w1cmc/garagelights/notes.txt

https://uglyduck.vajn.icu/ep/archive/2014/01/Making_a_better_HC_SR04_Echo_Locator.html
https://www.pcserviceselectronics.co.uk/arduino/Ultrasonic/electronics.html
