w1cmc/garagelights/mechanical/Bourns_3386F/POT_3386F.step

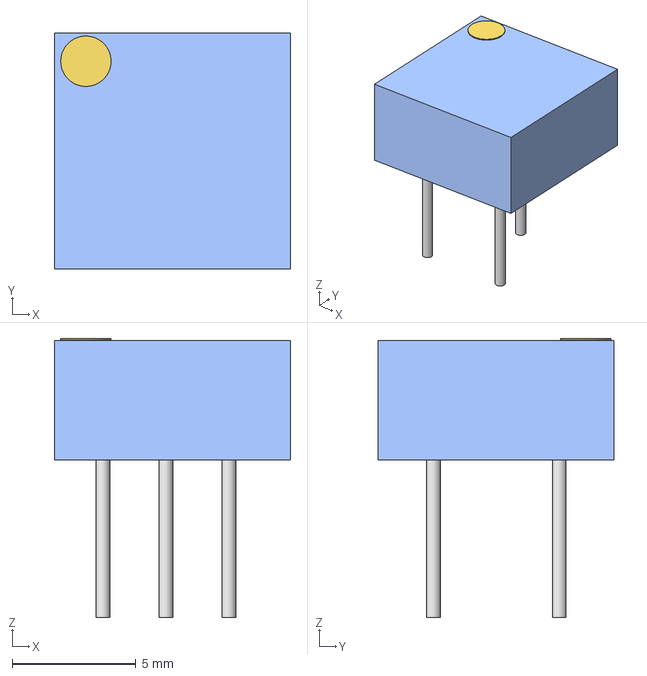
[picture p1: CAD file, 2026-04-26]
mechanical/Bourns_3386F/POT_3386F.step
9.53 x 9.53 x 11.3 mm
