w1cmc/garagelights/mechanical/FreeCAD/Sonar_Holder.FCStd

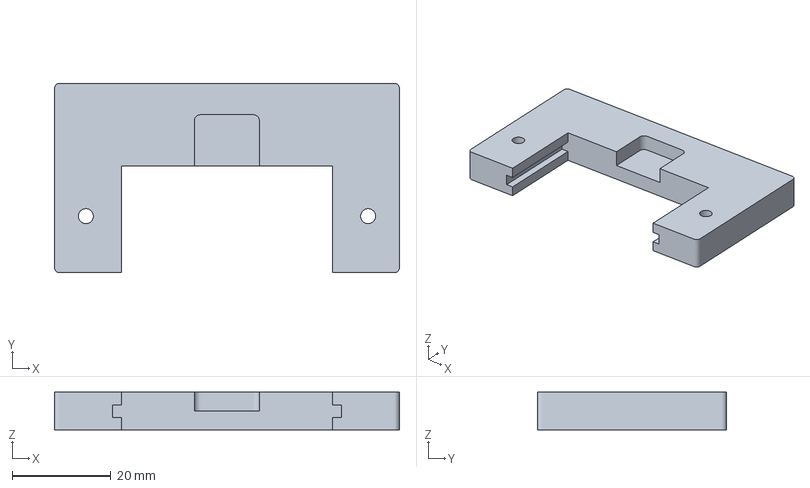
[picture p2: CAD file, 2026-05-07]
mechanical/FreeCAD/Sonar_Holder.FCStd
69.8 x 38.3 x 7.62 mm
