w1cmc/garagelights/mechanical/keystone-PN9900.STEP

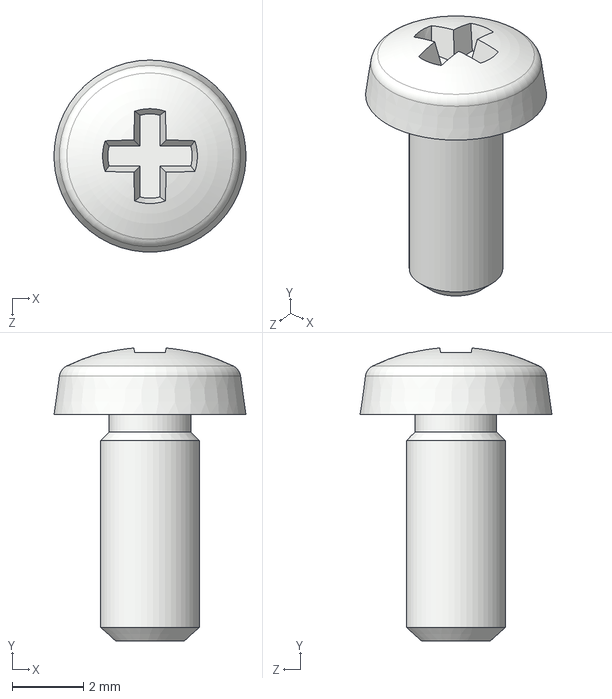
[picture p3: CAD file, 2026-05-08]
mechanical/keystone-PN9900.STEP
5.38 x 8.21 x 5.38 mm
