w1cmc/garagelights/mechanical/Keystone_5006/5006.step

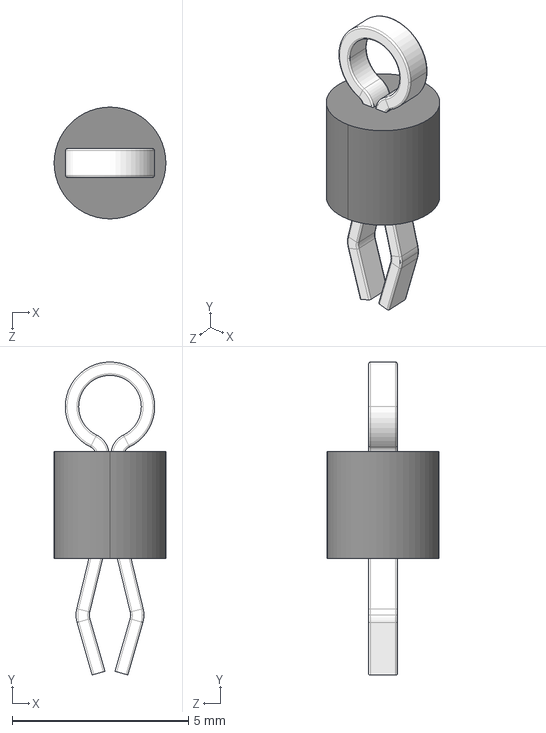
[picture p4: CAD file, 2026-04-10]
mechanical/Keystone_5006/5006.step
3.17 x 8.89 x 3.17 mm
