w1cmc/garagelights/mechanical/Keystone_8714/8714--3DModel-STEP-630548.STEP

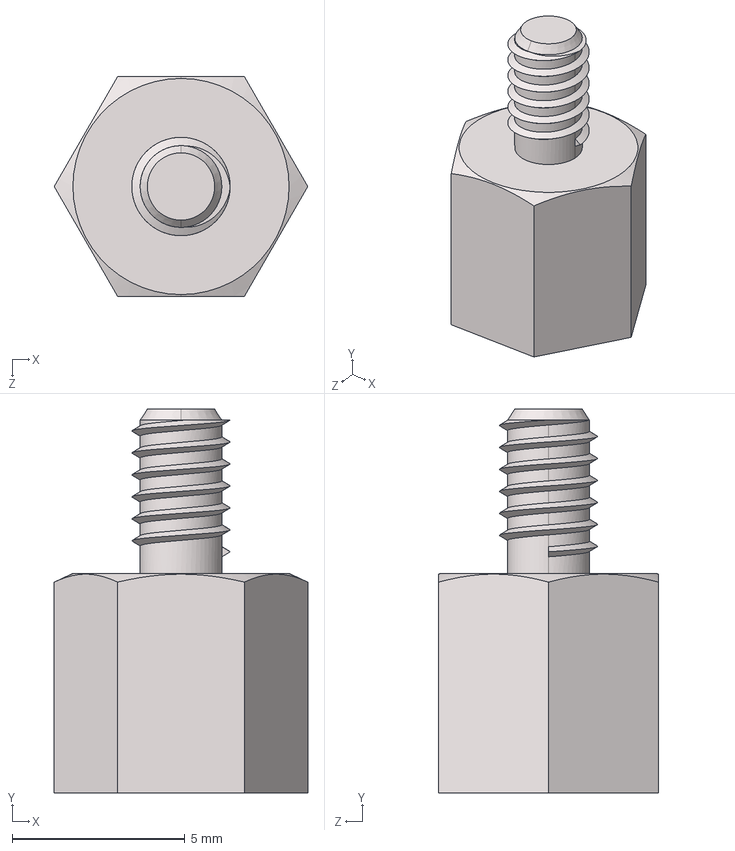
[picture p5: CAD file, 2026-05-04]
mechanical/Keystone_8714/8714--3DModel-STEP-630548.STEP
7.33 x 11.1 x 6.35 mm
