w1cmc/garagelights/mechanical/Schurter_6100_33/6100-33.STEP

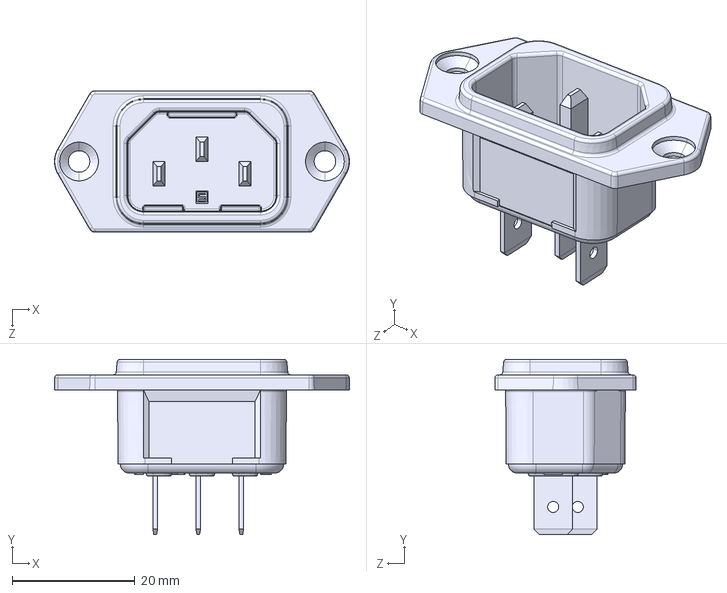
[picture p6: CAD file, 2026-05-04]
mechanical/Schurter_6100_33/6100-33.STEP
48.0 x 28.5 x 23.0 mm
