w1cmc/garagelights/mechanical/SSW-104-03-F-S-RA/SSW-104-03-F-S-RA.step

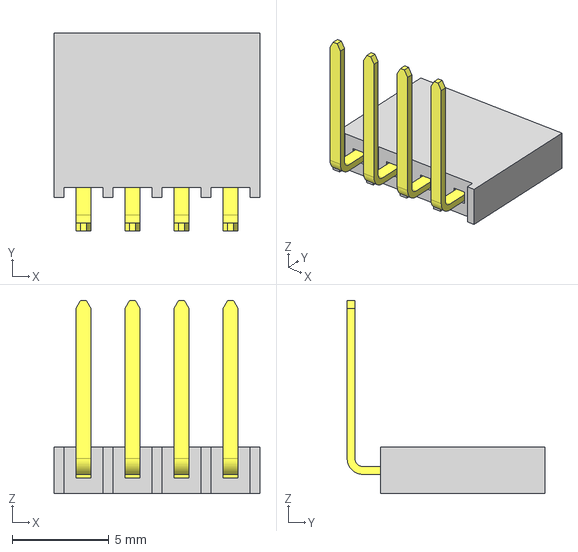
[picture p7: CAD file, 2026-04-10]
mechanical/SSW-104-03-F-S-RA/SSW-104-03-F-S-RA.step
10.7 x 10.2 x 10.0 mm
T1SSW-104-03-F-S-RA
P2SSW-104-03-F-S-RA
