w1cmc/garagelights/mechanical/SSW-106-01-L-S/SSW-106-01-L-S.stp

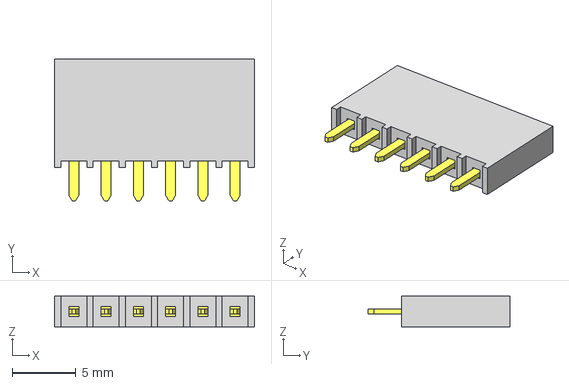
[picture p8: CAD file, 2026-04-10]
mechanical/SSW-106-01-L-S/SSW-106-01-L-S.stp
15.7 x 11.2 x 2.41 mm
T1SSW-106-01-L-S
P2SSW-106-01-L-S
