w1cmc/garagelights/mechanical/FreeCAD/garagelights-Sonar_Holder.step

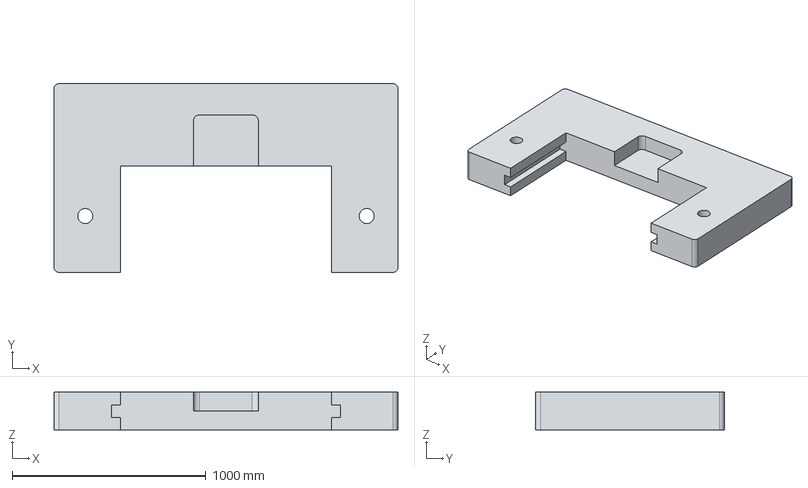
[picture p9: CAD file, 2026-05-07]
mechanical/FreeCAD/garagelights-Sonar_Holder.step
1774.2 x 973.8 x 193.5 mm
