w1cmc/garagelights/mechanical/keystone-PN9901.STEP

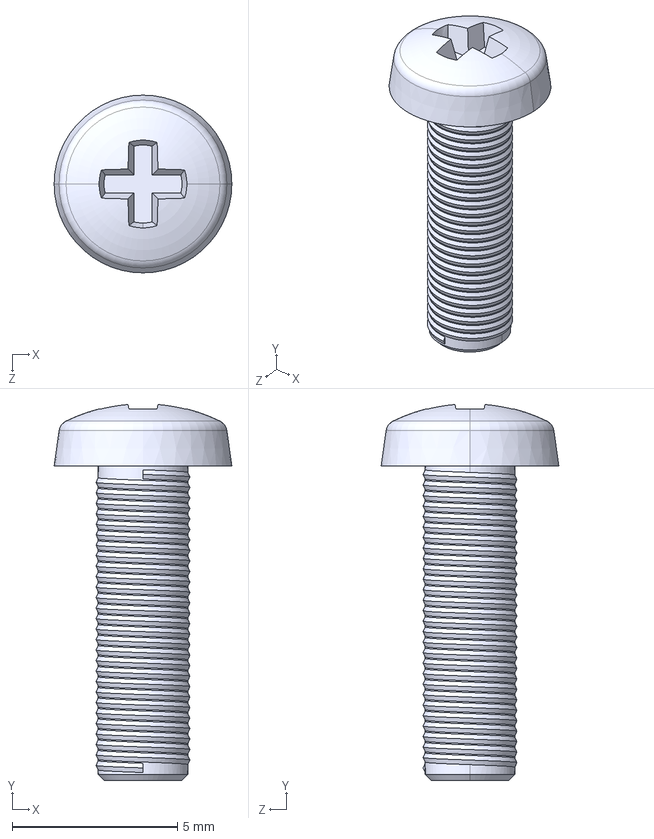
[picture p10: CAD file, 2026-05-08]
mechanical/keystone-PN9901.STEP
5.38 x 11.4 x 5.38 mm
