w1cmc/garagelights/mechanical/FreeCAD/Unnamed.FCStd

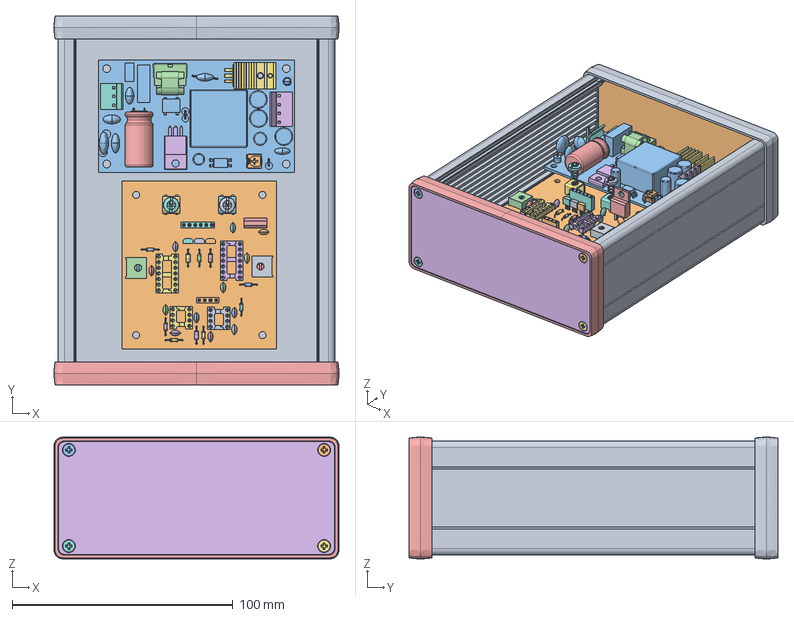
[picture p11: CAD file, 2026-04-09]
mechanical/FreeCAD/Unnamed.FCStd
129.0 x 167.0 x 55.1 mm
Back_Bezel
Back_Face
Back_Screw1
Back_Screw2
Front_Bezel
Front_Face
Front_Screw1
Front_Screw2
Main_Body
Front_Screw3
Front_Screw4
Back_Screw3
Back_Screw4
4-Pin Base 971208
ZPS20 Bed Component (M-B016-01-A) G6620380201
3-Pin Connector (2-Pin) 971208
Countersunk Head Screw M3x8mm — Standard
VR
ZPSA20-PCB (981208) — Configuration
Routed in Defeat — 0902
12.6 mm – 25 mm (For Bamboo Use)
Dangling Pendant: 10mm
Drip-tip: 10mm — Model A
CPD
Lead
Lead001
Lead002
C_Disc_D5.0mm_W2.5mm_P2.50mm
C_Disc_D5.0mm_W2.5mm_P2.50mm001
C_Disc_D5.0mm_W2.5mm_P2.50mm002
C_Disc_D5.0mm_W2.5mm_P2.50mm003
3386P-1-104LF
3386P-1-104LF001
3386P-1-104LF002
3386P-1-104LF003
3386P-1-104LF004
D_DO-35_SOD27_P7.62mm_Horizontal
D_DO-35_SOD27_P7.62mm_Horizontal001
DIP-8_W7.62mm_Socket
C_Disc_D5.0mm_W2.5mm_P2.50mm004
R_Axial_DIN0204_L3.6mm_D1.6mm_P7.62mm_Horizontal
R_Axial_DIN0204_L3.6mm_D1.6mm_P7.62mm_Horizontal001
TO-220-3_Vertical
C_Disc_D5.0mm_W2.5mm_P2.50mm005
CPD001
Lead004
Lead005
Lead006
C_Disc_D5.0mm_W2.5mm_P2.50mm006
D_DO-35_SOD27_P7.62mm_Horizontal003
D_DO-35_SOD27_P7.62mm_Horizontal004
R_Axial_DIN0204_L3.6mm_D1.6mm_P7.62mm_Horizontal002
DIP-8_W7.62mm_Socket001
PinSocket_1x04_P2.54mm_Vertical
C_Disc_D5.0mm_W2.5mm_P2.50mm007
D_DO-35_SOD27_P7.62mm_Horizontal006
D_DO-35_SOD27_P7.62mm_Horizontal007
R_Axial_DIN0204_L3.6mm_D1.6mm_P7.62mm_Horizontal003
DIP-14_W7.62mm_Socket
C_Disc_D5.0mm_W2.5mm_P2.50mm008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
