w1cmc/garagelights/mechanical/keystone-PN9902.STEP

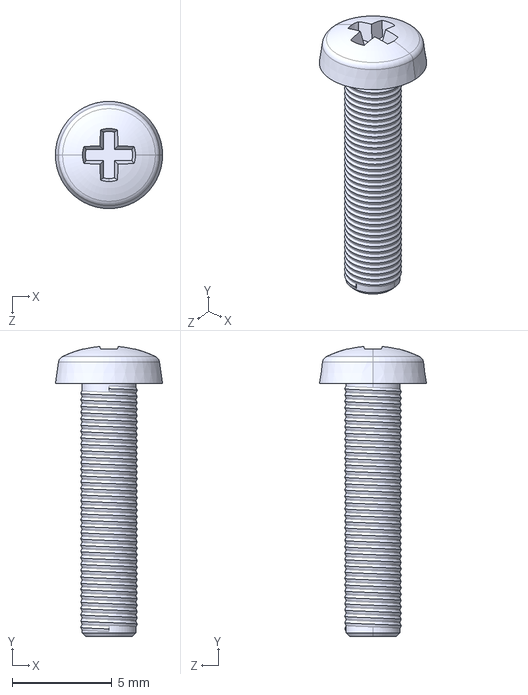
[picture p12: CAD file, 2026-05-08]
mechanical/keystone-PN9902.STEP
5.38 x 14.6 x 5.38 mm
