w1cmc/garagelights/mechanical/RC1122DWC.stp

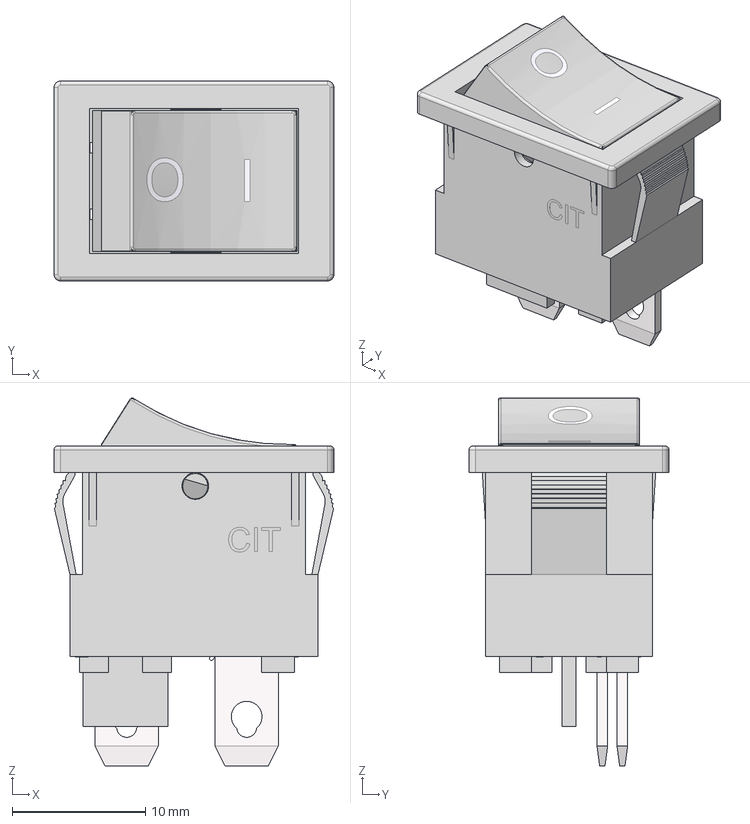
[picture p13: CAD file, 2026-05-04]
mechanical/RC1122DWC.stp
21.0 x 15.0 x 27.6 mm
Body DC
Actuator D
Terminal DC x 2
