w1cmc/garagelights/mechanical/garagelights_RevB.step

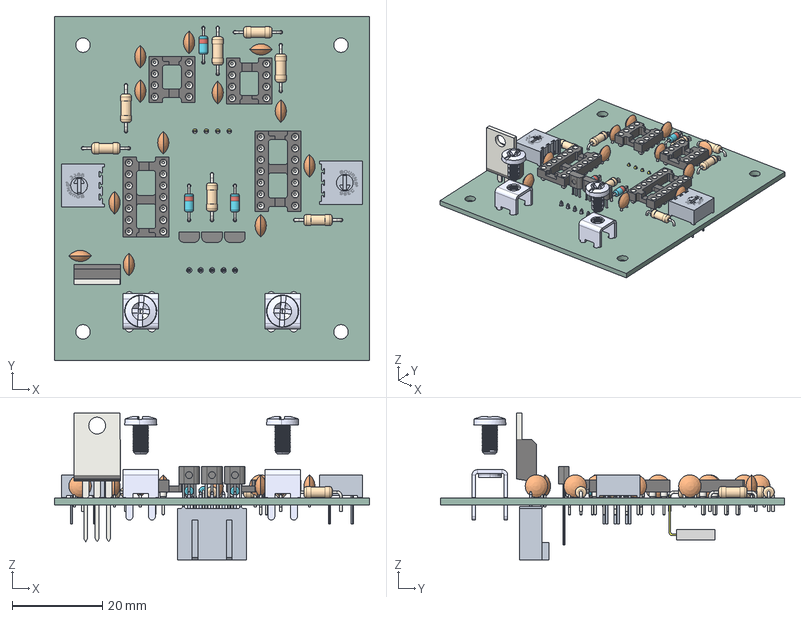
[picture p14: CAD file, 2026-04-28]
mechanical/garagelights_RevB.step
69.8 x 76.2 x 32.5 mm
CPD x 3
Lead x 3
C_Disc_D5.0mm_W2.5mm_P2.50mm x 12
3386f001 x 2
D_DO-35_SOD27_P7.62mm_Horizontal x 3
DIP-8_W7.62mm_Socket x 2
R_Axial_DIN0207_L6.3mm_D2.5mm_P10.16mm_Horizontal x 7
TO-220-3_Vertical
DIP-14_W7.62mm_Socket x 2
T1SSW-104-03-F-S-RA
P2SSW-104-03-F-S-RA
garagelights_PCB
