w1cmc/garagelights/mechanical/zpsa20_3d.step

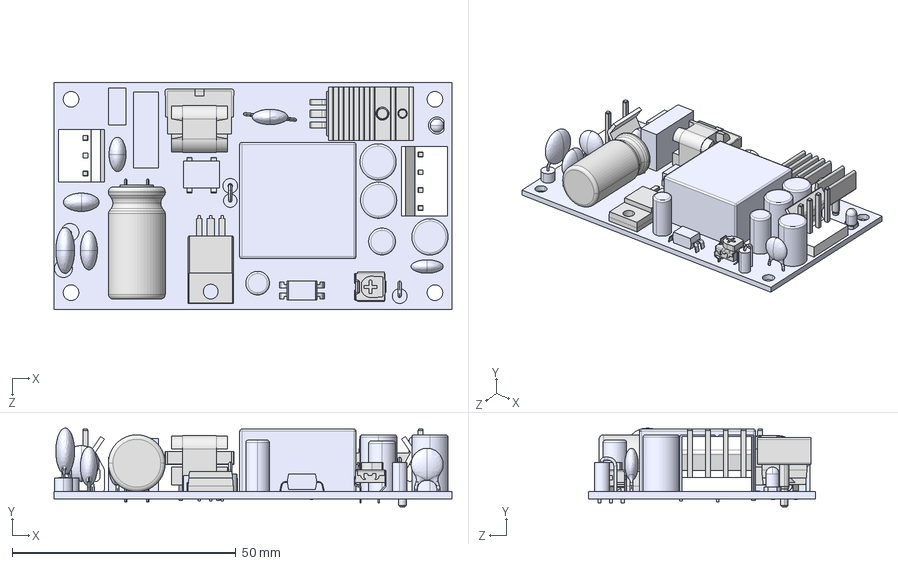
[picture p15: CAD file, 2026-04-09]
mechanical/zpsa20_3d.step
88.9 x 17.6 x 50.8 mm
4 PIN插座971208
ZPS20散熱片(M-B016-01-A)G6620380201
3 PIN插座(2PIN)971208
･ｭﾀY､Qｦrﾁｳｵｷ M3x8mm_ｹwｳ]
VR
ZPSA20-PCBªO(981208)_¹w³]
變壓器0902
12.6mm-25mm電容
電晶體10mm-彎角
電晶體10mm-彎角A
