w1cmc/garagelights/mechanical/3386P-1-104LF.STEP

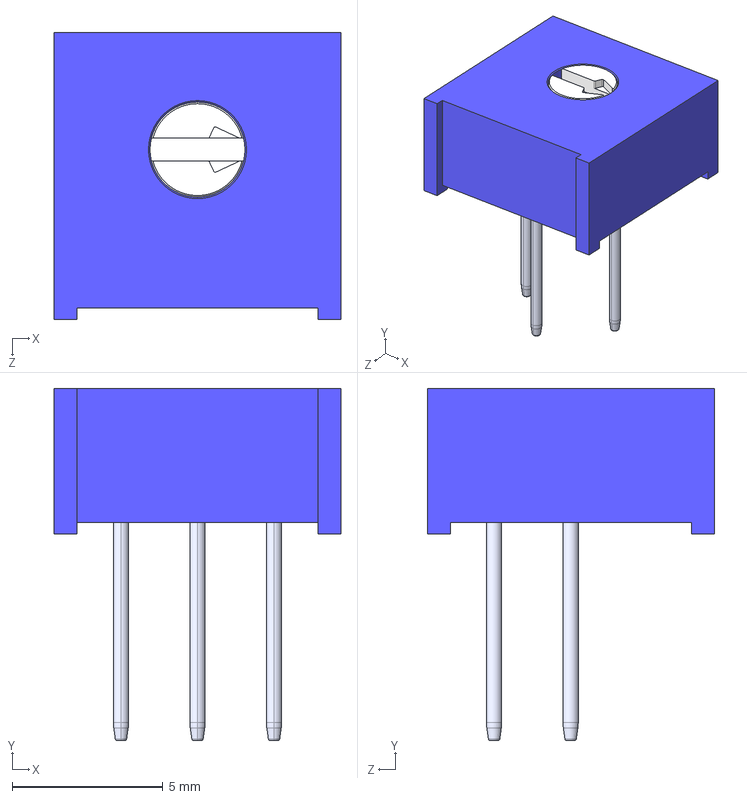
[picture p16: CAD file, 2026-04-09]
mechanical/3386P-1-104LF.STEP
9.53 x 11.7 x 9.53 mm
