w1cmc/garagelights/mechanical/8191.step

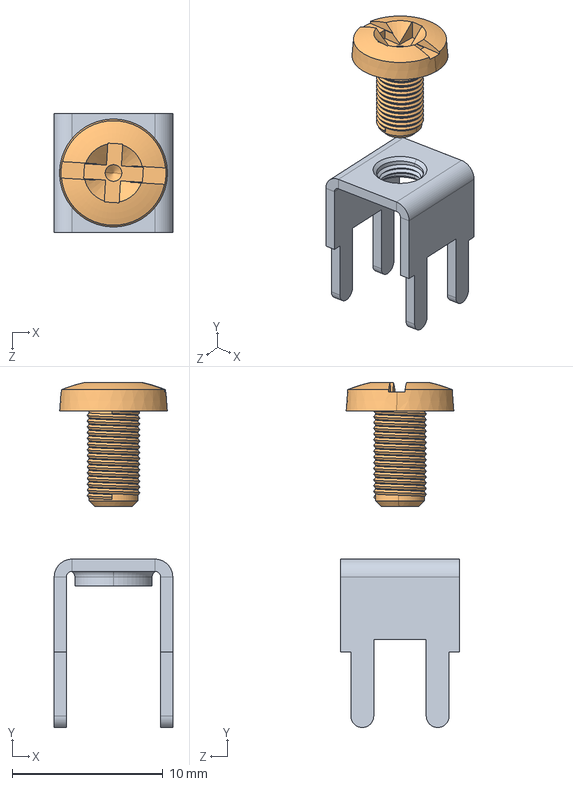
[picture p17: CAD file, 2026-04-09]
mechanical/8191.step
7.87 x 22.9 x 7.87 mm
