w1cmc/garagelights/mechanical/E-Line-BULK.stp

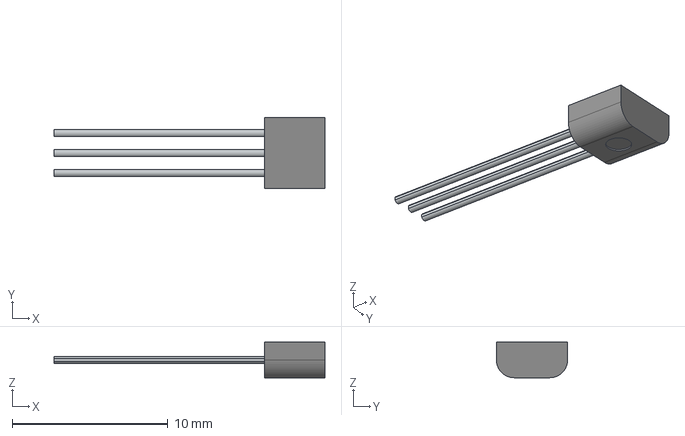
[picture p18: CAD file, 2026-04-09]
mechanical/E-Line-BULK.stp
17.4 x 4.57 x 2.28 mm
CPD
Lead
