w1cmc/garagelights/(list of files, cad)

Other CAD files:
mechanical/Keystone_9900/9900--3DModel-STEP-630548.STEP
mechanical/3686K68_Circuit Board Enclosure.STEP
mechanical/Bourns_3386F/3386f001.stp
mechanical/FreeCAD/garagelights-Sonar_Holder.3mf
mechanical/FreeCAD/garagelights.FCStd
mechanical/Molex_705430004/705430004.stp
mechanical/Molex_901361106/901361106.stp
mechanical/garagelights.step
