w1cmc/garagelights/sim/garagelights.asc

C1: cap; 0.1e-6
C2: cap; 0.1e-6
C3: cap; 0.1e-6
C4: cap; 0.1e-6
D1: diode; 1N914
R1: res; 470k
R2: res; 4.7k
R3: res; 4.7k
R4: res; 100
R5: res; 1
U1: NE555
U2: NE555
V1: voltage; 5
Named nets: 0, OUT, VCC
.tran 1
