w1cmc/garagelights/garagelights.kicad_pcb

## KiCad design garagelights.kicad_pcb (2026-04-27)

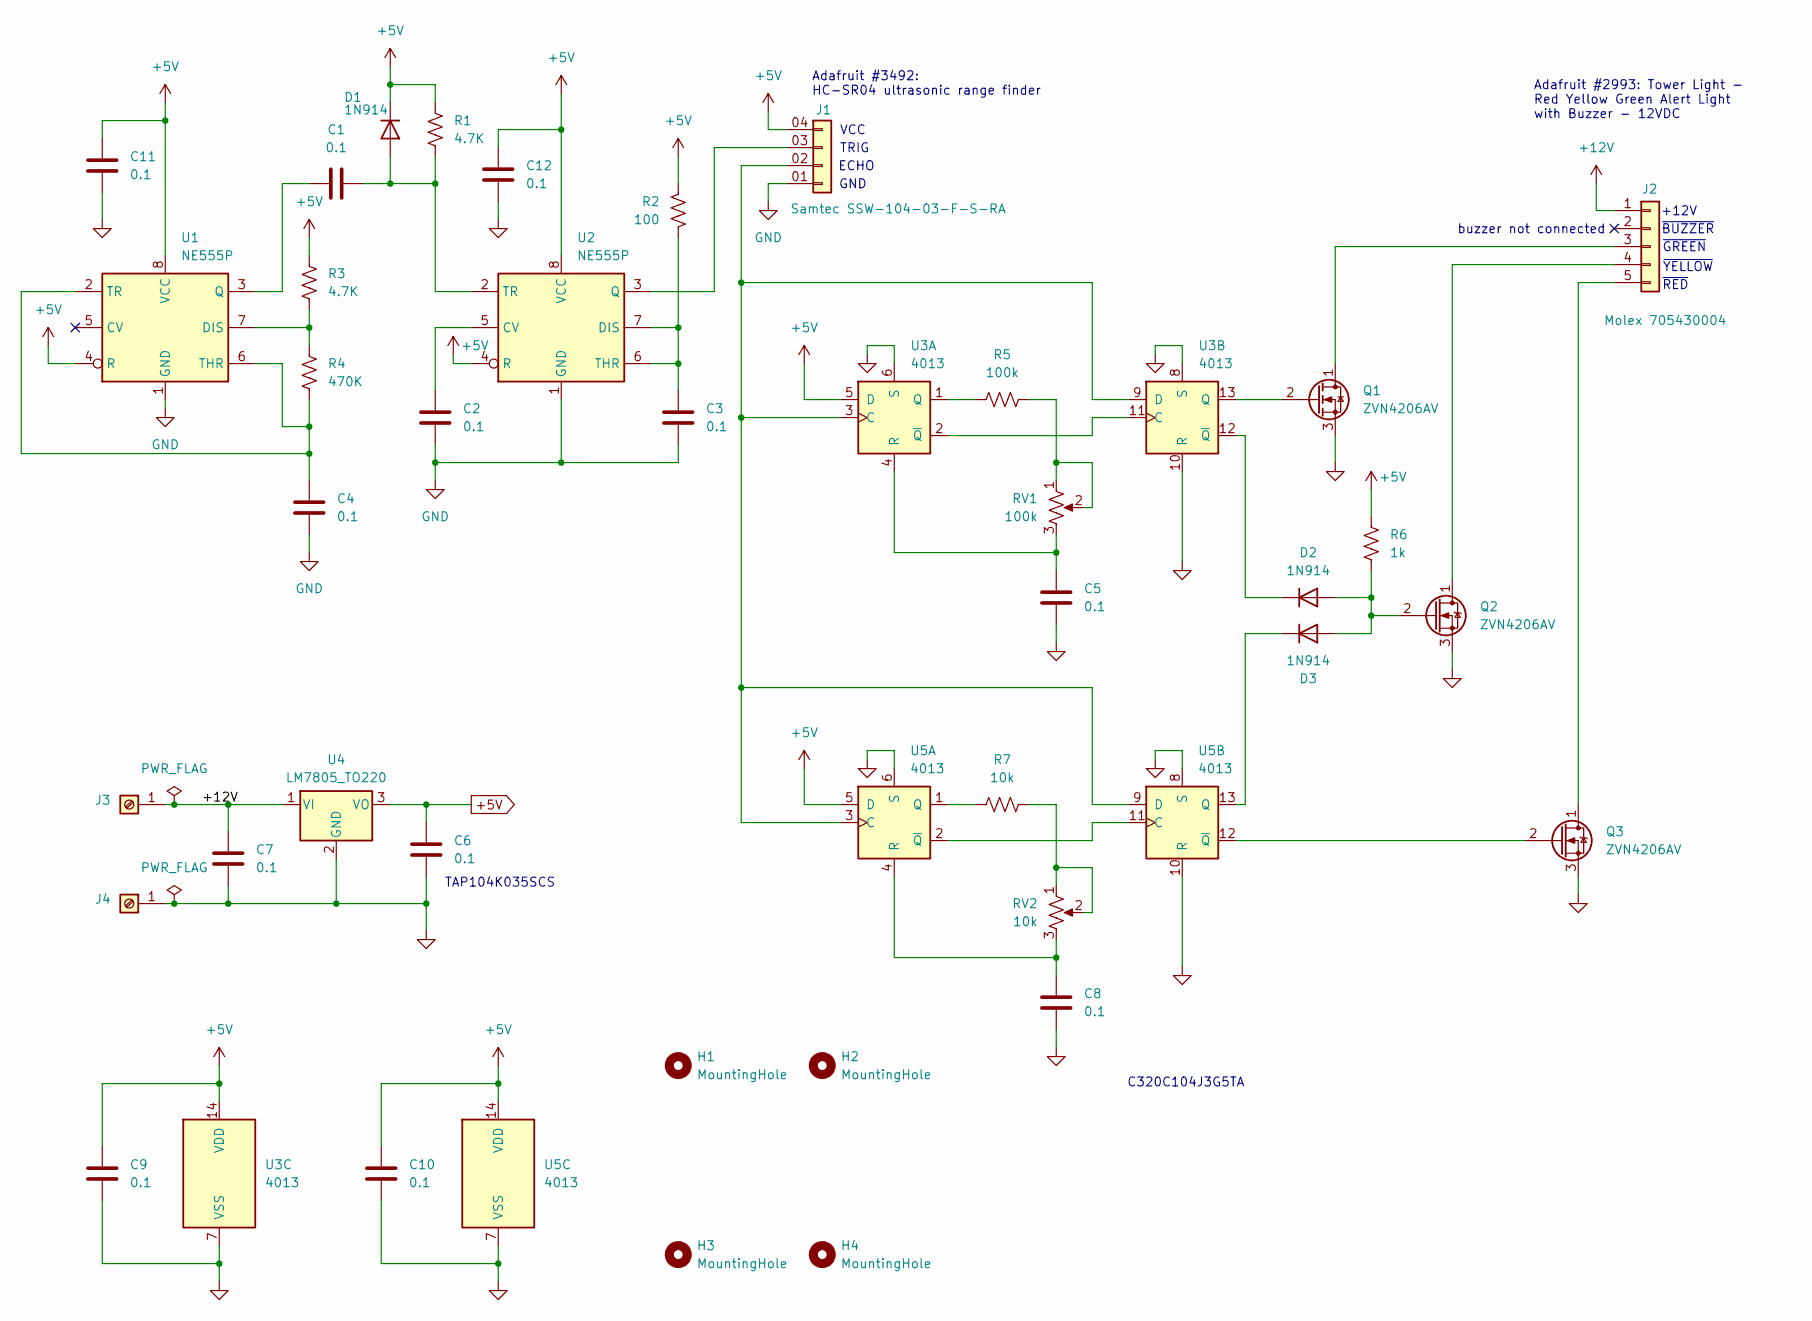
[picture p19: schematic garagelights.kicad_sch, Garage Lights]

Parts:
C1, C2, C3, C4, C5, C6, C7, C8, C9, C10, C11, C12: 0.1; C_Disc_D5.0mm_W2.5mm_P2.50mm
D1, D2, D3: 1N914; D_DO-35_SOD27_P7.62mm_Horizontal
H1, H2, H3, H4: MountingHole; MountingHole_3.2mm_M3
J1: Samtec SSW-104-03-F-S-RA; SAMTEC_SSW-104-03-F-S-RA
J2: Molex 705430004; CONN_SDA-70543-xxxx_05_MOL
J3, J4: Screw_Terminal_01x01; KEYSTONE_8191
Q1, Q2, Q3: ZVN4206AV; TO-92S
R1, R3: 4.7K; R_Axial_DIN0207_L6.3mm_D2.5mm_P10.16mm_Horizontal
R2: 100; R_Axial_DIN0207_L6.3mm_D2.5mm_P10.16mm_Horizontal
R4: 470K; R_Axial_DIN0207_L6.3mm_D2.5mm_P10.16mm_Horizontal
R5: 100k; R_Axial_DIN0207_L6.3mm_D2.5mm_P10.16mm_Horizontal
R6: 1k; R_Axial_DIN0207_L6.3mm_D2.5mm_P10.16mm_Horizontal
R7: 10k; R_Axial_DIN0207_L6.3mm_D2.5mm_P10.16mm_Horizontal
RV1: 100k; POT_3386F
RV2: 10k; POT_3386F
U1, U2: NE555P; DIP-8_W7.62mm_Socket
U3, U5: 4013; DIP-14_W7.62mm_Socket
U4: LM7805_TO220; TO-220-3_Vertical

Connections:
+5V: C6.1, C9.1, C10.1, C11.1, C12.1, D1.1 (K), J1.04 (Pin_1), R1.1, R2.1, R3.1, R6.1, U1.4 (R), U1.8 (VCC), U2.4 (R), U2.8 (VCC), U3.5 (D), U3.14 (VDD), U4.3 (VO), U5.5 (D), U5.14 (VDD)
+12V: C7.1, J2.1, J3.1 (Pin_1_1), U4.1 (VI)
GND: C2.2, C3.2, C4.2, C5.2, C6.2, C7.2, C8.2, C9.2, C10.2, C11.2, C12.2, J1.01 (Pin_4), J4.1 (Pin_1_1), Q1.3 (S), Q2.3 (S), Q3.3 (S), U1.1 (GND), U2.1 (GND), U3.6 (S), U3.7 (VSS), U3.8 (S), U3.10 (R), U4.2 (GND), U5.6 (S), U5.7 (VSS), U5.8 (S), U5.10 (R)
unnamed: C1.2, D1.2 (A), R1.2, U2.2 (TR)
unnamed: D2.2 (A), D3.2 (A), Q2.2 (G), R6.2
unnamed: D2.1 (K), U3.12 (~Q)
unnamed: D3.1 (K), U5.13 (Q)
unnamed: J1.03 (Pin_2), U2.3 (Q)
unnamed: J1.02 (Pin_3), U3.3 (C), U3.9 (D), U5.3 (C), U5.9 (D)
unnamed: J2.3, Q1.1 (D)
unnamed: J2.4, Q2.1 (D)
unnamed: J2.5, Q3.1 (D)
unnamed: Q1.2 (G), U3.13 (Q)
unnamed: Q3.2 (G), U5.12 (~Q)
unnamed: R5.2, RV1.1, RV1.2
unnamed: R7.2, RV2.1, RV2.2
unnamed: R3.2, R4.1, U1.7 (DIS)
unnamed: C1.1, U1.3 (Q)
unnamed: C4.1, R4.2, U1.2 (TR), U1.6 (THR)
unnamed: C2.1, U2.5 (CV)
unnamed: C3.1, R2.2, U2.6 (THR), U2.7 (DIS)
unnamed: R5.1, U3.1 (Q)
unnamed: C5.1, RV1.3, U3.4 (R)
unnamed: U3.2 (~Q), U3.11 (C)
unnamed: R7.1, U5.1 (Q)
unnamed: C8.1, RV2.3, U5.4 (R)
unnamed: U5.2 (~Q), U5.11 (C)

Notes on the sheet:
Adafruit #3492: HC-SR04 ultrasonic range finder
~{GREEN}
TAP104K035SCS
VCC
ECHO
Adafruit #2993: Tower Light - Red Yellow Green Alert Light with Buzzer - 12VDC
GND
buzzer not connected
~{BUZZER}
+12V
TRIG
~{YELLOW}
~{RED}
C320C104J3G5TA

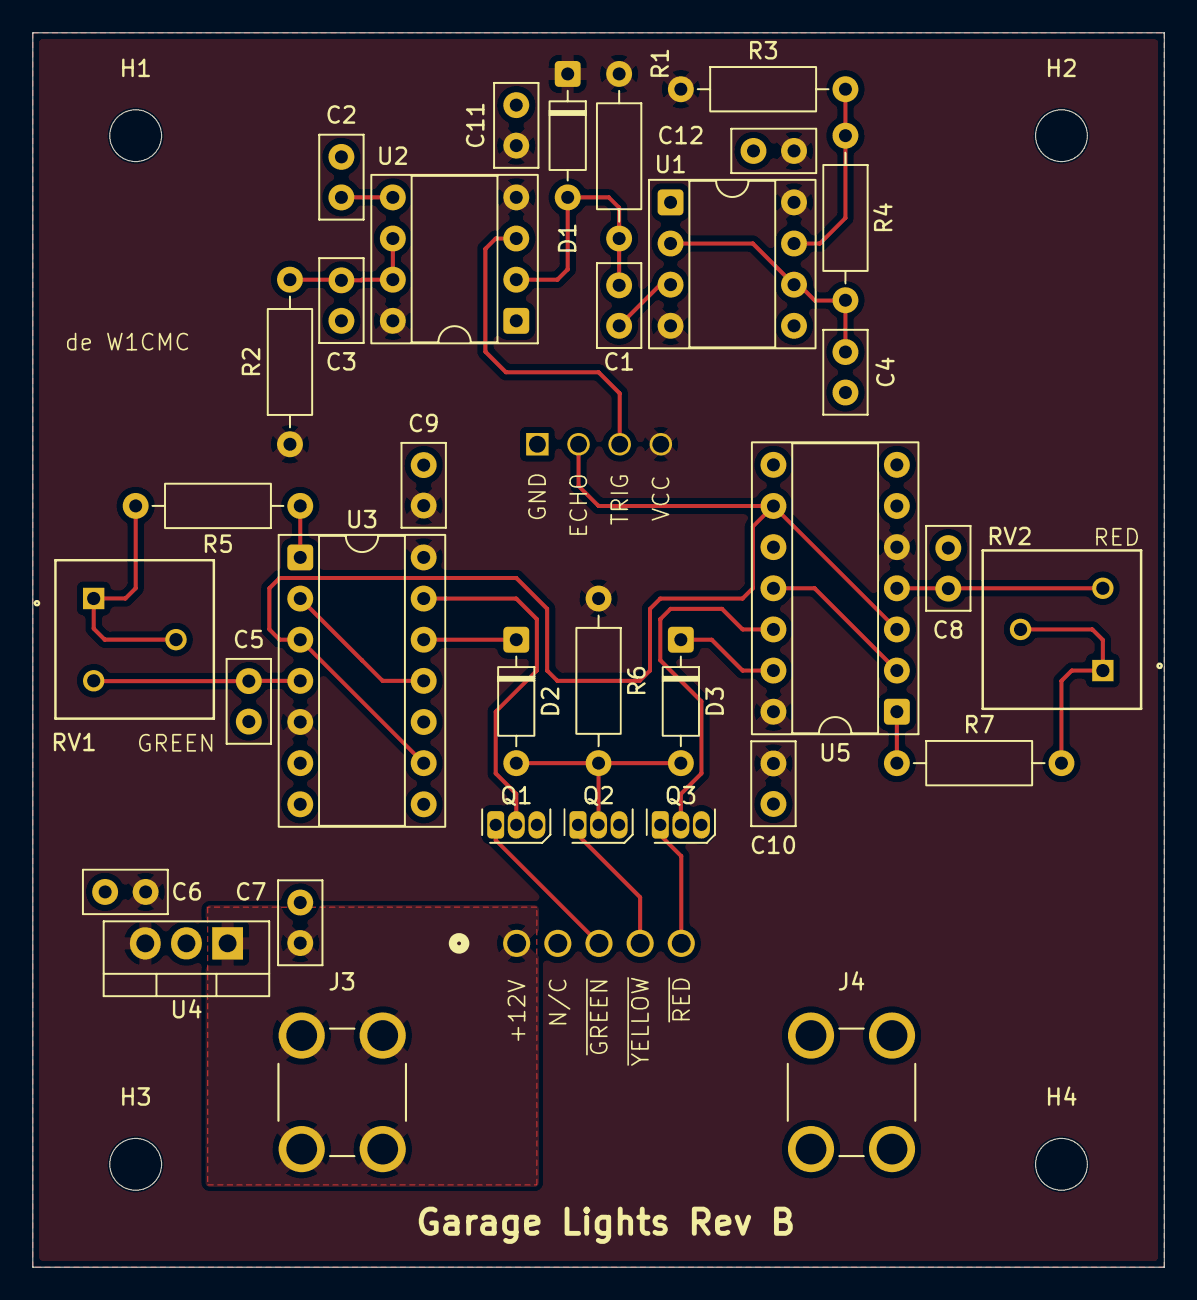
[picture p20: board garagelights.kicad_pcb from above]

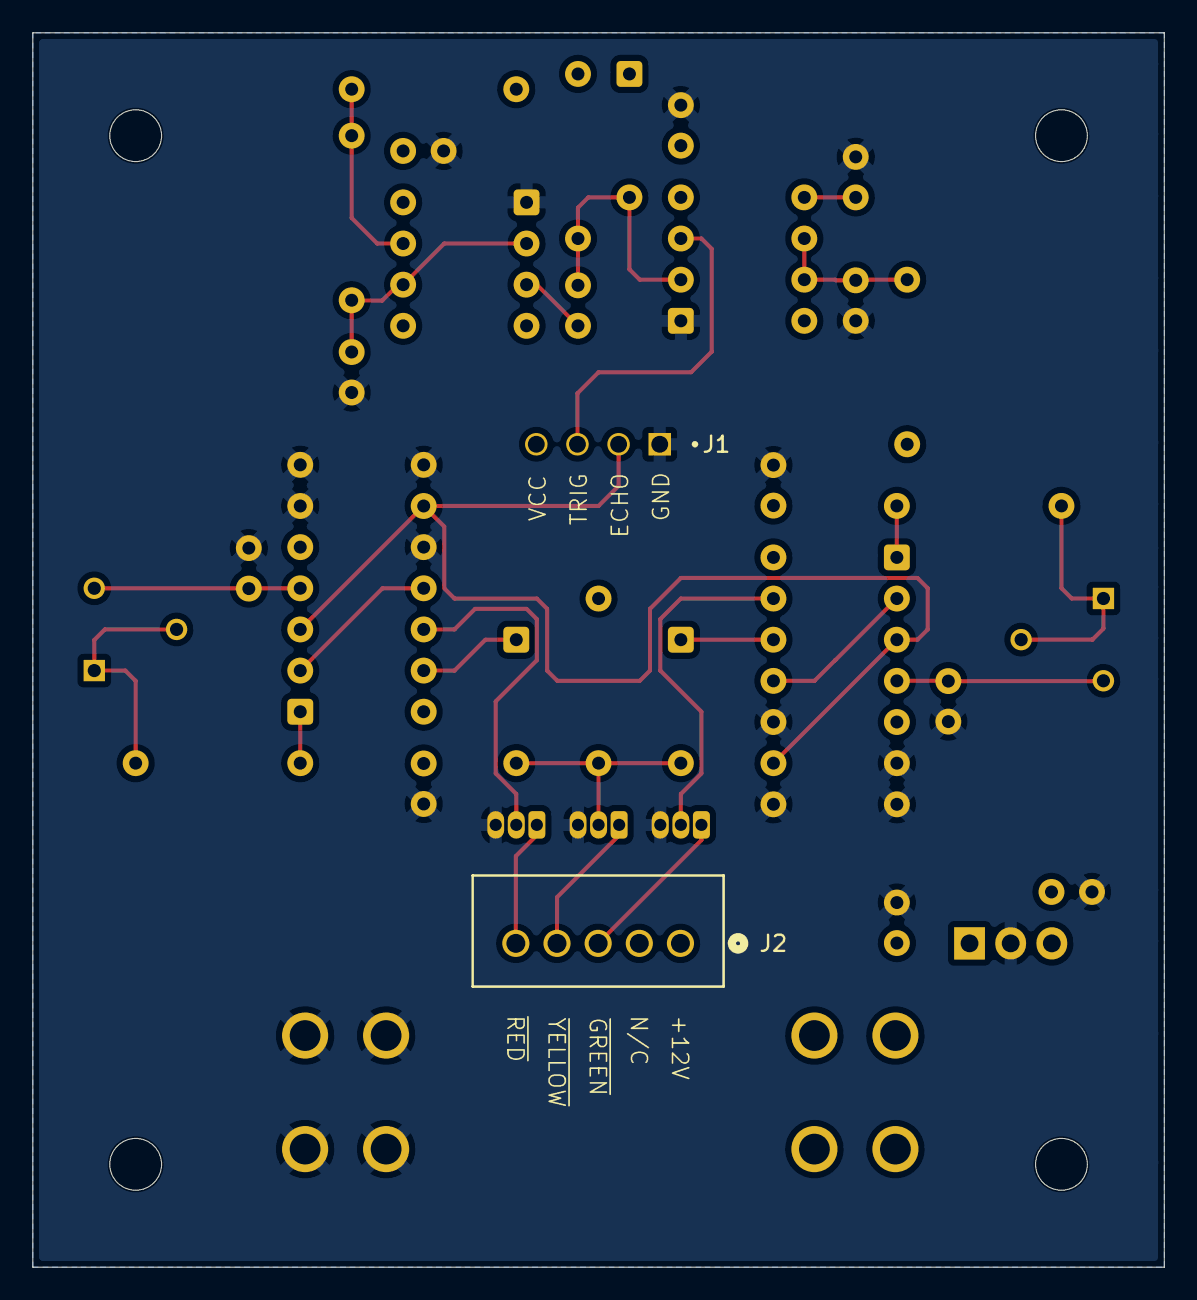
[picture p21: board garagelights.kicad_pcb from below]

Board: 2 copper layers, 69.8 x 76.2 mm, 40 parts (2 on the bottom side), 27 nets.
