w1cmc/garagelights/(commit log)

2025-11-02 First working prototype
    [garagelights.kicad_pcb, garagelights.kicad_sch]
2025-11-03 Added FETs and yellow light
    [garagelights.kicad_sch]
2026-04-08 mostly finished layout
    [garagelights.kicad_pcb, garagelights.kicad_sch]
2026-04-09 Added screw terminals and mounting holes
    Also working towards reducing the number of layers to two.
    [garagelights.kicad_pcb, garagelights.kicad_sch]
2026-04-09 Kinda sorta Rev_A
    Finished the layout and brought it down to two layers, one of which
    is a ground plane. Imported missing 3D models.
    [3386P-1-104LF.STEP, 3686K68_Circuit Board Enclosure.STEP, 8191.step, E-Line-BULK.stp, garagelights.kicad_pcb, garagelights.kicad_sch]
2026-04-09 started mechanical design
    [Unnamed.FCStd, garagelights.kicad_pcb, garagelights.step, zpsa20_3d.step]
2026-04-10 Moved the connectors to the bottom side
    Makes the mechanical design easier. Also some tweaks to reduce
    inductance on the +5V net.
    [garagelights.kicad_pcb]
2026-04-10 Change "PING" to "TRIG" to better match HC-SR04 nomenclature.
    [garagelights.kicad_pcb]
2026-04-10 Spec Samtec connectors for the socket headers.
    Also more fussing with position and text.
    [SSW-104-03-F-S-RA.step, SSW-104-03-F-S-RA.stp, SSW-106-01-L-S.stp, garagelights.kicad_pcb, garagelights.kicad_sch]
2026-04-10 Put the mounting holes into the schematic.
    So that we don't keep losing them when we update the layout from
    the schematic.
    [garagelights.kicad_pcb, garagelights.kicad_sch]
2026-04-10 Rev A: as submitted to Osh Park order #fmnAZ4b4
    [5006.step, 901361106.stp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]
2026-04-11 Added a PWR_FLG and exclusion to clear ERCs
    [garagelights.FCStd, garagelights.kicad_sch]
2026-04-13 Added plot output directory for schematics
2026-04-13 Added LTSpice simulation of the clocking circuit
2026-04-13 git-ignore KiCAD cache and backups
2026-04-15 Changed the timing capacitors: 1 uF ceramic C0G isn't a thing.
    [garagelights.kicad_pcb, garagelights.kicad_sch]
2026-04-26 Update to KiCAD 10.0, replace J2 with 5-pin
    J2 was 6-pin, but the ground pin was superfluous. The light tower
    is switched on the low side, so there is no ground conductor.
    [705430004.stp, garagelights.FCStd, garagelights.kicad_pcb, garagelights.kicad_sch]
2026-04-26 Fixed a couple of boo-boos:
    1. Bigger resistors
    2. Correct footprint for pots
    [3386f001.stp, POT_3386F.step, garagelights.kicad_pcb, garagelights.kicad_sch]
2026-04-27 Outputs for Rev B
    [garagelights-B_Cu.gbr, garagelights-B_Mask.gbr, garagelights-B_Paste.gbr, garagelights-B_Silkscreen.gbr, garagelights-Edge_Cuts.gbr, garagelights-F_Cu.gbr, garagelights-F_Mask.gbr, garagelights-F_Paste.gbr]
2026-04-28 More mechanical work, bump the revision letter on the Schematic
    Mostly done with mechanical holes and pockets.
    [garagelights.FCStd, garagelights.kicad_sch, garagelights_RevB.step]
2026-05-04 Added power entry and switch
    [6100-33.STEP, 8714--3DModel-STEP-630548.STEP, 9900--3DModel-STEP-630548.STEP, RC1122DWC.stp, garagelights.FCStd]
2026-05-05 Added HC-SR04 model to the mechanical design.
    [garagelights.FCStd]
2026-05-05 Added BoM
    [garagelights.csv]
2026-05-05 more churn; made changes and then unmade them
    [garagelights.FCStd]
2026-05-06 added sonar holder
    [garagelights.FCStd]
2026-05-07 Exported STEP file for sonar holder
    [garagelights-Sonar_Holder.step]
2026-05-07 Refinements to sonar holder
    The constraints are better: a single value sets the clearance
    around the HC-SR04 PCB.
    [garagelights.FCStd]
2026-05-07 add 3-d print files
    [Sonar_Holder.FCStd, garagelights-Sonar_Holder.3mf]
2026-05-08 Added long screws through sonar holder.
    And STEP file for short screws.
    [garagelights.FCStd, keystone-PN9901.STEP, keystone-PN9902.STEP]
2026-05-08 Added the short screws.
    [garagelights.FCStd, keystone-PN9900.STEP]
2026-05-24 Move the power entry mechanicals to a subdirectory.
    Schurter 6100-33.
    [6100-33.STEP]
