w1cmc/garagelights/(notices)

Notices in the files:
mechanical/SSW-106-01-L-S/SSW-106-01-L-S.stp:
author */ ('License CC BY-ND 4.0'),
